kathleenthemachine/Power-Converters_CEV/(list of files, drawings)

Other design files:
5V_LowCurr/5V_1A.PrjPcb
5V_LowCurr/5V_1A_Max.SchDoc
5V_LowCurr/5V_1A_PCB.PcbDoc
5V_LowCurr/Components.SchLib
5V_LowCurr/PcbLib1.PcbLib
5V_LowCurr/Schlib1.SchLib
Horn_12V/12V_Horn.PrjPcb
Horn_12V/12V_Horn_PCB.PcbDoc
Horn_12V/12V_Horn_Schematic.SchDoc
Horn_12V/PcbLib1.PcbLib
Horn_12V/Schlib1.SchLib
